juncho26/SpendBox/hardware/case/README.md

# Case

3D-printable case, designed in Fusion. The files are in STEP format:

| File | Part |
|---|---|
| SpendBox-Front.step | front shell with the screen window |
| SpendBox-Back.step | back shell |
| SpendBox-Button_Up.step | BOOT (up) button cap |
| SpendBox-Button_Down.step | PWR (down) button cap |

Import them into your slicer, or export STL from any CAD program.

Print settings: PLA, 0.08mm layers, supports
