juncho26/SpendBox/THIRD_PARTY.md

# Third-party material

| What | Where | License |
|---|---|---|
| QR Code generator library (Project Nayuki) | `core/gfx/third_party/qrcodegen.c/.h` | MIT |
| Barlow Condensed Bold font (rasterized into `core/gfx/font_data.c`) | `tools/BarlowCondensed-Bold.ttf`, `tools/Barlow-OFL.txt` | SIL Open Font License 1.1 |
| DejaVu Sans Mono Bold (rasterized into `core/gfx/font_data.c`) | generated by `tools/genfont.py` | Bitstream Vera / DejaVu license (free to use and embed) |
| ESP-IDF 5.4 (build dependency, not copied here) | https://github.com/espressif/esp-idf | Apache-2.0 |

The e-paper start-up sequence and waveform tables in `firmware/main/hal_epd.c` follow Waveshare's own
ESP-IDF example for this board, re-written in C.
