juncho26/SpendBox/docs/images/screen-over-limit.png

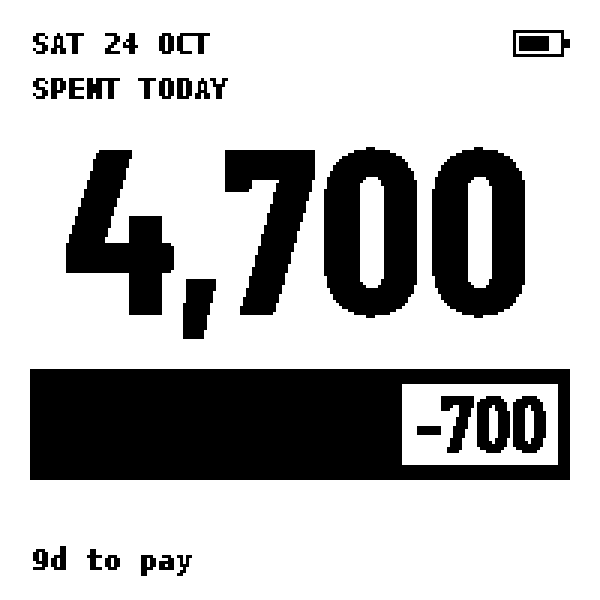
docs/images/screen-over-limit.png
