juncho26/SpendBox/hardware/case/SpendBox-Back.step

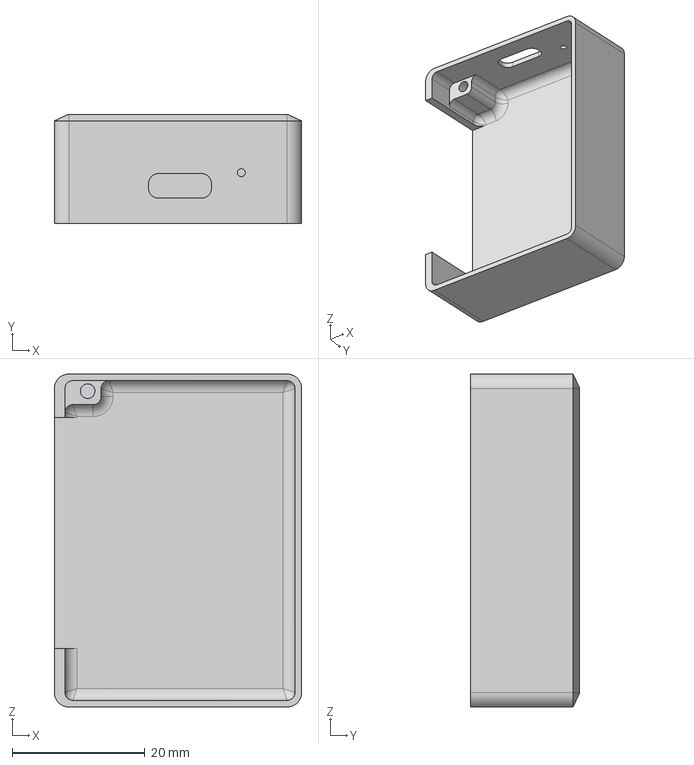
[picture p3: CAD file, 2026-10-25]
hardware/case/SpendBox-Back.step
37.3 x 16.5 x 50.2 mm
