juncho26/SpendBox/hardware/case/SpendBox-Front.step

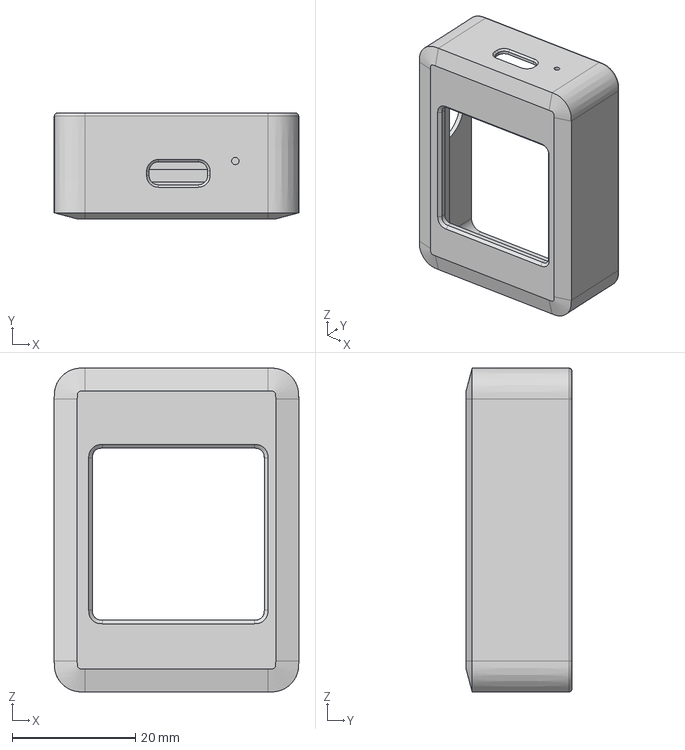
[picture p4: CAD file, 2026-10-25]
hardware/case/SpendBox-Front.step
39.7 x 17.2 x 52.6 mm
