juncho26/SpendBox/hardware/case/SpendBox-Button_Down.step

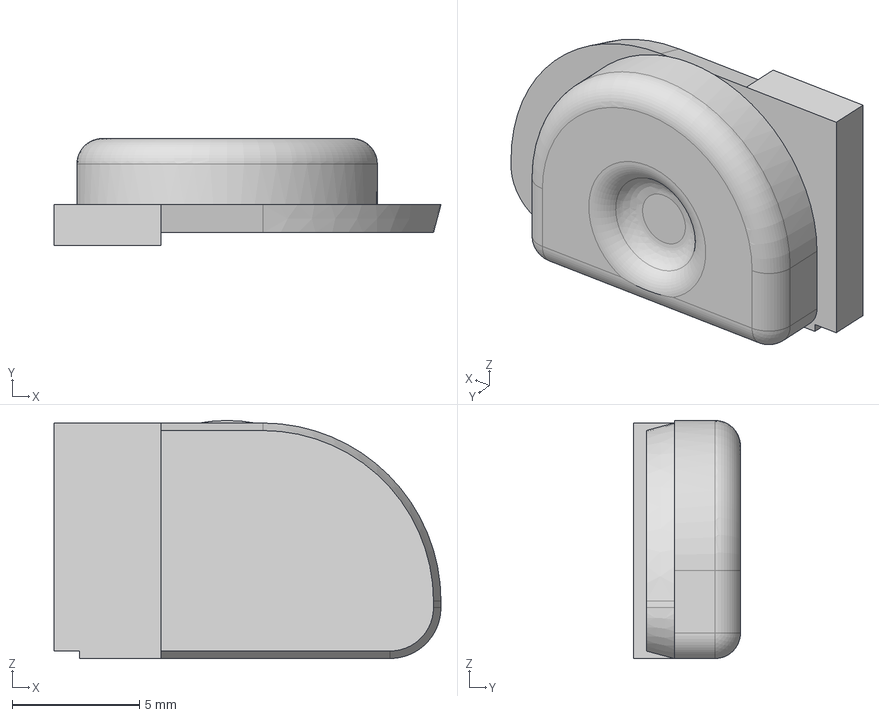
[picture p5: CAD file, 2026-10-25]
hardware/case/SpendBox-Button_Down.step
15.2 x 4.20 x 9.35 mm
