juncho26/SpendBox/hardware/case/SpendBox-Button_Up.step

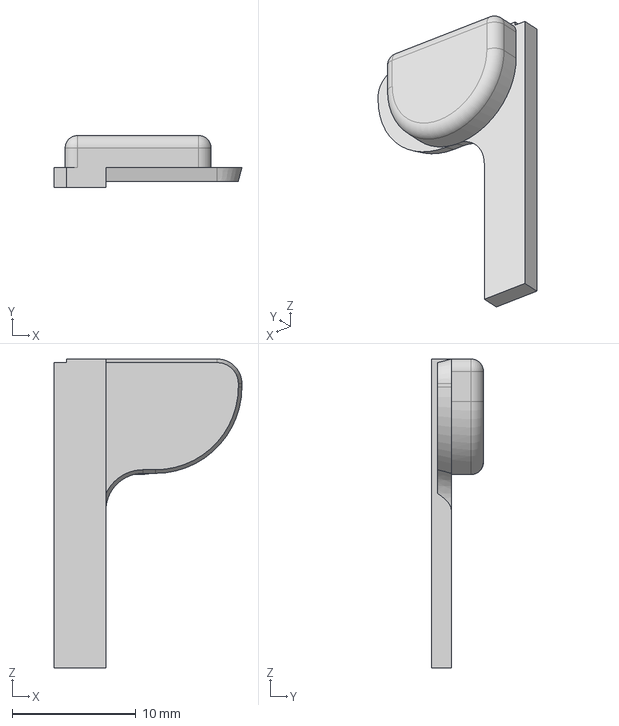
[picture p6: CAD file, 2026-10-25]
hardware/case/SpendBox-Button_Up.step
15.2 x 4.20 x 25.0 mm
