juncho26/SpendBox/(commit log)

2026-11-07 Replace screen image with device image in README
    Updated images in README to better represent SpendBox.
2026-11-07 Revise case README with part details and print settings
    Updated README with detailed part descriptions and printing instructions.
2026-11-07 Revise print settings in README
    Updated print settings and removed assembly instructions.
